cverd001/Senior-Design/pics/IMG_3942.JPG

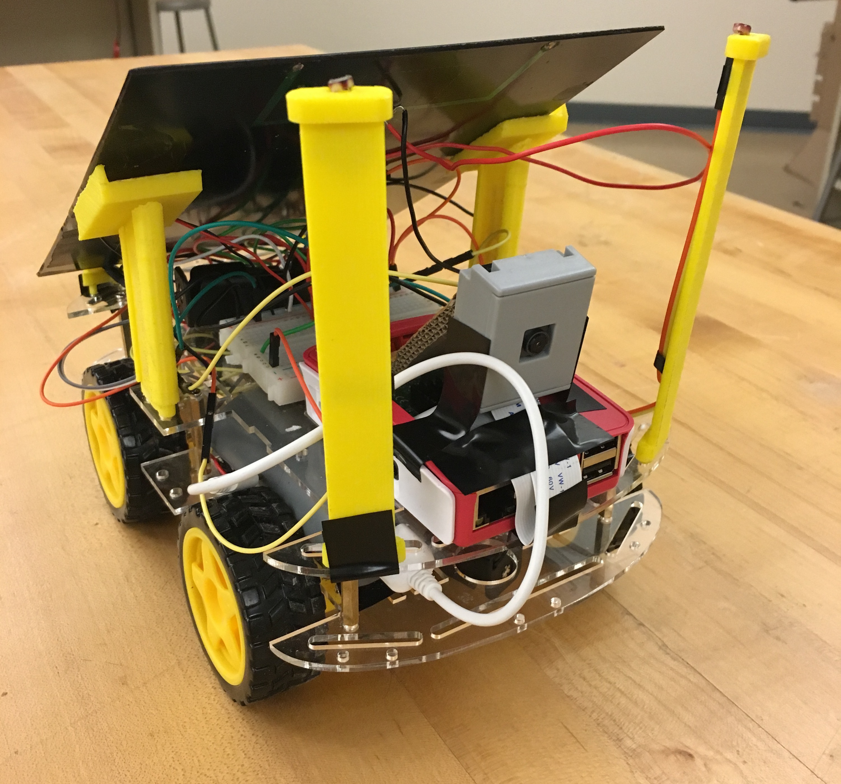
pics/IMG_3942.JPG
