cverd001/Senior-Design/pics/IMG_2810.JPG

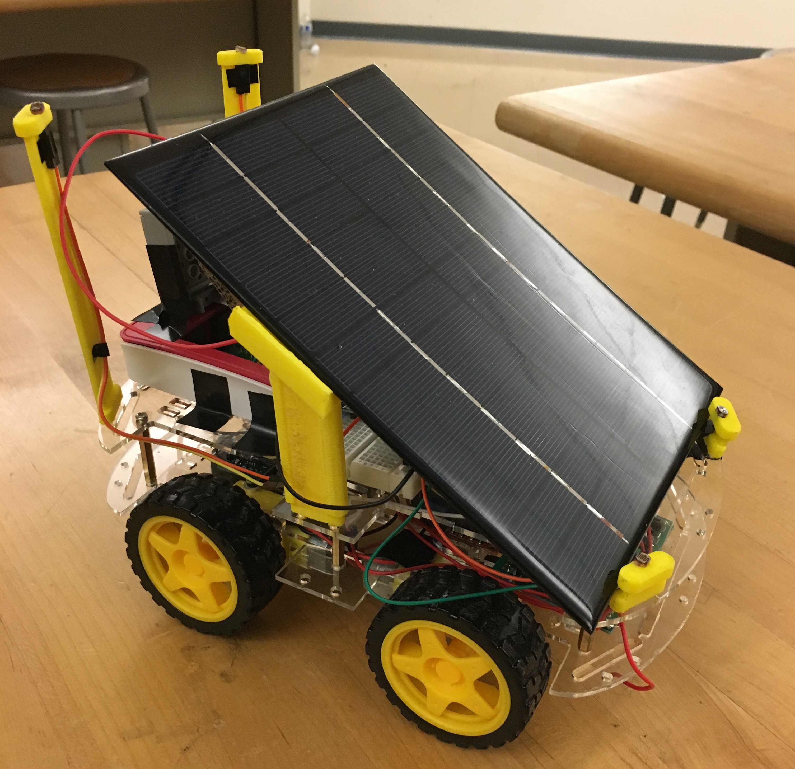
pics/IMG_2810.JPG
