cverd001/Senior-Design/MainMotions/Photoresistor.ino

/* Simple test of the functionality of the photo resistor

Connect the photoresistor one leg to pin 0, and pin to +5V
Connect a resistor (around 10k is a good value, higher
values gives higher readings) from pin 0 to GND. (see appendix of arduino notebook page 37 for schematics).

----------------------------------------------------

           PhotoR     10K
 +5    o---/\/\/--.--/\/\/---o GND
                  |
 Pin 0 o-----------

----------------------------------------------------
*/

//int lightPin = 19;  //define a pin for Photo resistor
//int ledPin=8;     //define a pin for LED

/*
void setup()
{
    pinMode(lightPin,INPUT);
    Serial.begin(9600);  //Begin serial communcation
    //pinMode( ledPin, OUTPUT );
}

void loop()
{ 
    Serial.println(analogRead(lightPin)); //Write the value of the photoresistor to the serial monitor.
    delay(100); //short delay for faster response to light.
}
*/
