cverd001/Senior-Design/main_motions/Vision.ino

//teensy tells pi when to start
//teensy moves 360 on imu
//rpi sends high digital output every time it sees a new max @angle
//teensy turns to best angle and moves forward until sensors read light

//teensy2piPin
//pi2teensyPin

int spotflag = 0;
int maxDegId = 0;

void startScan() {
  digitalWrite(teensy2piPin, HIGH);  //start signal
  laserTone();
  Serial.println("Sending start signal to pi");
}

void stopScan() {
  digitalWrite(teensy2piPin, LOW);  //start signal
  Serial.println("Sending stop signal to pi");
}

void headToLight() {
  moveBack();
  while (true) {
    int lightness = readSolarVoltage();
    if (lightness >= 95) {
      break;
    }
  }
  brake();
  victoryTone();
  delay(2000);
}



void turnRightBurstImu() {
  int i = 0;
  float temp = 0;
  Serial.println("Initializing IMU...");
  mpu.resetFIFO();
//  for (int i = 0; i < 175; i++) {
//    testIMU();
//  }
  testIMU();
  float initYaw = ypr[0] * 180 / M_PI + 180;
//  Serial.println("Finished initializing IMU. Entering turning...");
  for (i = 0; i < 36; i++) {
    imuRight2(10,0.99);
    delay(600);
//    Serial.print("Right turn number: ");
//    Serial.println(i);
    if (digitalRead(pi2teensyPin) == HIGH) {
      bootTone();
      maxDegId = i;
      spotflag = 1;
//      Serial.print("Raspberry Pi sent HIGH signal! New max set to ");
//      Serial.println(i);
    }
  }
  laserTone();
  Serial.println("Done with right turns!");
}

void returnToPos()
{
  imuRight2(maxDegId * 10.0,1.0);
}
void scan() {
  mew();
  startScan();
  turnRightBurstImu();  //finds best angle
  stopScan();
  meow2();
  delay(200);
  if (spotflag == 1) {  // spots detected, do heading
    returnToPos();
    chirp();
    headToLight();        //goes to light
    Spin();
    victoryTone();
    Tracking(); //fix
  }
  else {                // no spots found, do perform_traverse
    PerformTraverseAlg();
  }
}

void scanPlus() {
  for (int i = 0; i < 1100; i++) {
    testIMU();
    Serial.println(i);
  }
  scaleFastTone();
  scan();
}
