cverd001/Senior-Design/(commit log)

2017-12-23 testing encoder with distance
2018-01-12 case Search in movement.ino added
2018-01-14 updated movement algorithm and adc reading, but with photoresistors pins undefined
2018-01-14 modified Search case, added ReturnToMax case
2018-01-14 changed variable names, added comments, fixed small things
    [Movement.ino]
2018-01-19 added photoresistor file and switched unused io pins to output
2018-01-23 testing broken switch
2018-01-25 fixed turns/veering a little, updated search alg
    [Motors.ino, Movement.ino, main_motions.ino]
2018-02-08 added solar voltage pin and function
2018-02-09 fixed motor speed mistake, added IMU files
    [Imu.ino, Motors.ino, Move.ino, main_motions.ino]
2018-02-16 add calibrated turning func
2018-02-22 fixed overflow issue and modified calibrated turning
    [CalibratedTurning.ino, main_motions.ino]
2018-02-22 removed useless print
2018-02-23 added unverified calibrating func, removed useless codes, commented useless print
2018-02-25 add communication with teensy in computer vision remove old version code filter out unwanted contour sizes
2018-02-26 added Vision tab and vision scan functions in Calibrated Turning
2018-02-28 tweaked calibrated turning
2018-03-02 Fixed Computer Vision scan and imu turning
    [CalibratedTurning.ino, Imu.ino, Menu.ino, Motors.ino, TraverseAlg.ino, Vision.ino, main_motions.ino]
